iseegr8tfuldeadppl/BraillePrintingMachine/Other/DrawingMachine/gcode/48386743_604268526693747_9118755841934098432_n.png

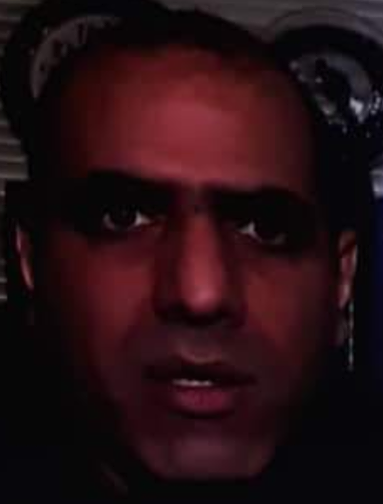
Other/DrawingMachine/gcode/48386743_604268526693747_9118755841934098432_n.png
