iseegr8tfuldeadppl/BraillePrintingMachine/Other/DrawingMachine/gcode/ok2.jpg

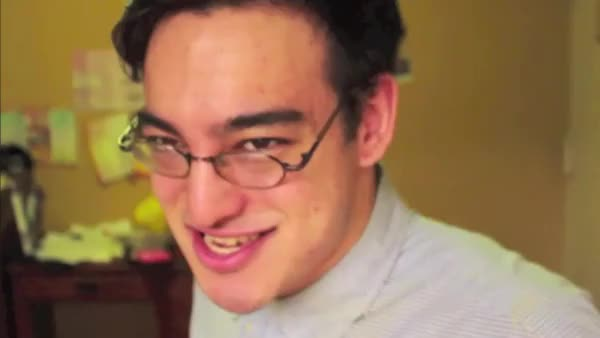
Other/DrawingMachine/gcode/ok2.jpg
