iseegr8tfuldeadppl/BraillePrintingMachine/Report/TODO REPORT.txt

X send report by email to urself n try to view it on browser to test pictures being visible
X follow given architecture 
X rename sources
X no stupid history
X don't talk about what you feel/think/thought
X project does not contain "you", "me",  "i"
X change your main goal according to what she said
X you have to format all the paragraphs using the tool option she mentioned
X remove any will and future
x remove any our and thought and think and assume and you

X wrrite entire report but in titles only
