iseegr8tfuldeadppl/BraillePrintingMachine/3DModels/braille.jpg

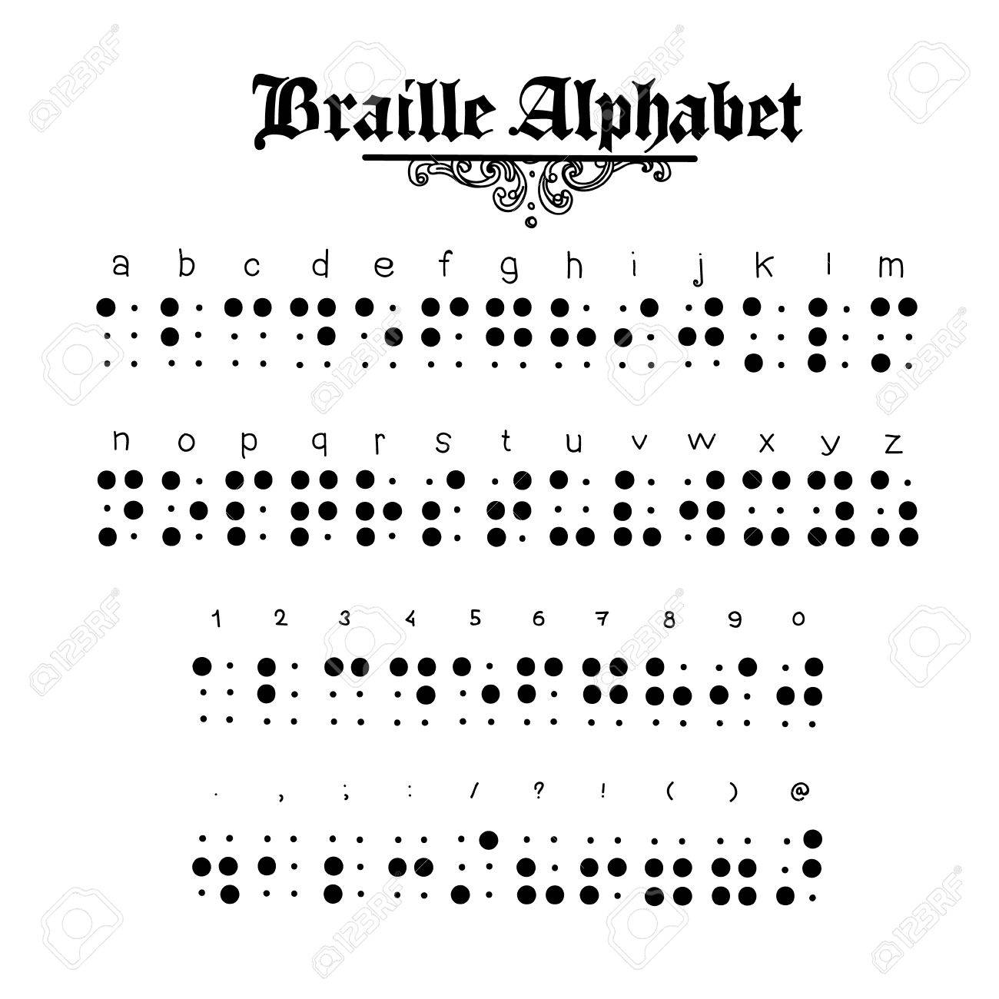
3DModels/braille.jpg
