iseegr8tfuldeadppl/BraillePrintingMachine/Other/DrawingMachine/gcode/2fake.png

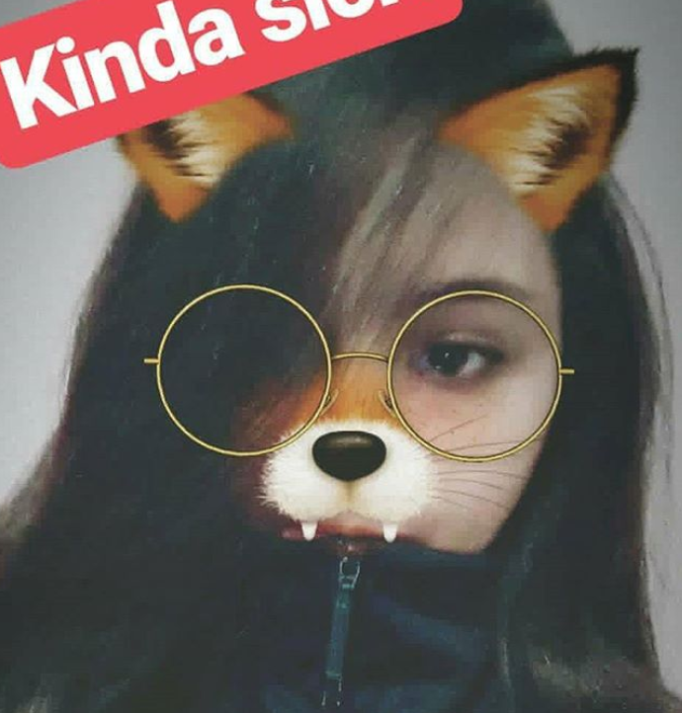
Other/DrawingMachine/gcode/2fake.png
