iseegr8tfuldeadppl/BraillePrintingMachine/Other/DrawingMachine/gcode/49095503_364993957612211_6874582120640020480_n.jpg

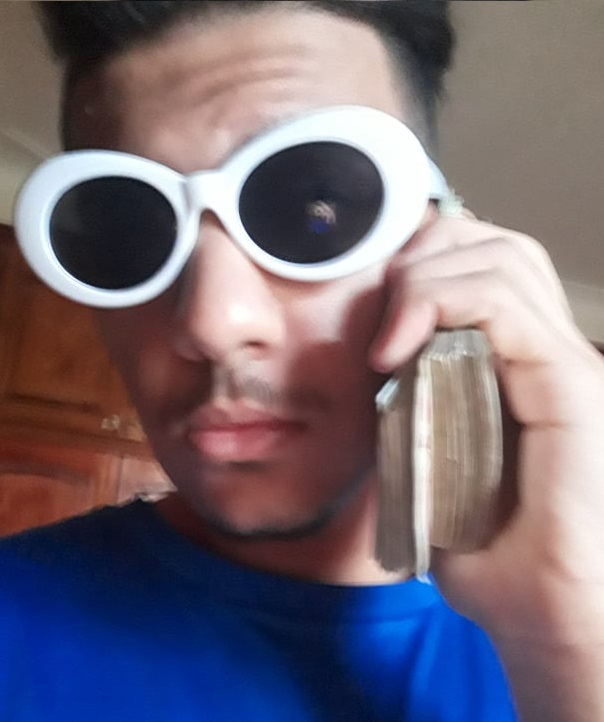
Other/DrawingMachine/gcode/49095503_364993957612211_6874582120640020480_n.jpg
