iseegr8tfuldeadppl/BraillePrintingMachine/Other/DrawingMachine/gcode/54405427_401156530697718_4848583370659069952_n.jpg

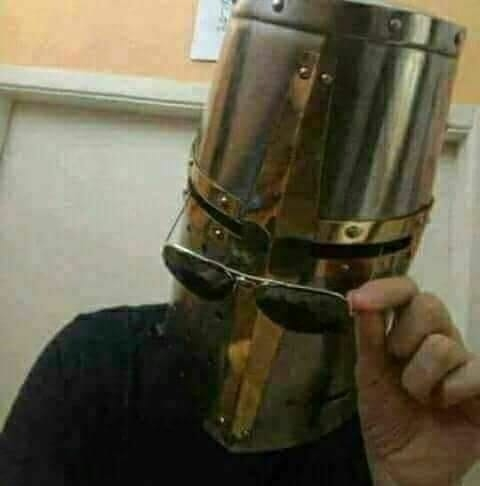
Other/DrawingMachine/gcode/54405427_401156530697718_4848583370659069952_n.jpg
