iseegr8tfuldeadppl/BraillePrintingMachine/Other/DrawingMachine/gcode/748185382cc3f726acdb8a884f4bbdc9.gif

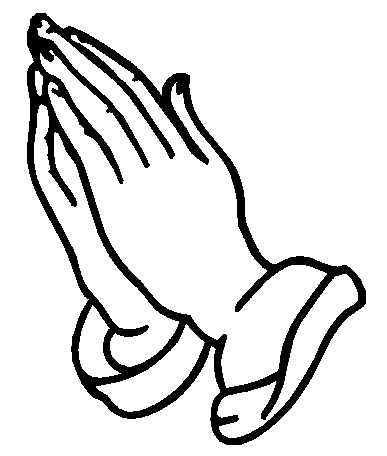
Other/DrawingMachine/gcode/748185382cc3f726acdb8a884f4bbdc9.gif
