iseegr8tfuldeadppl/BraillePrintingMachine/Other/DrawingMachine/gcode/ani.png

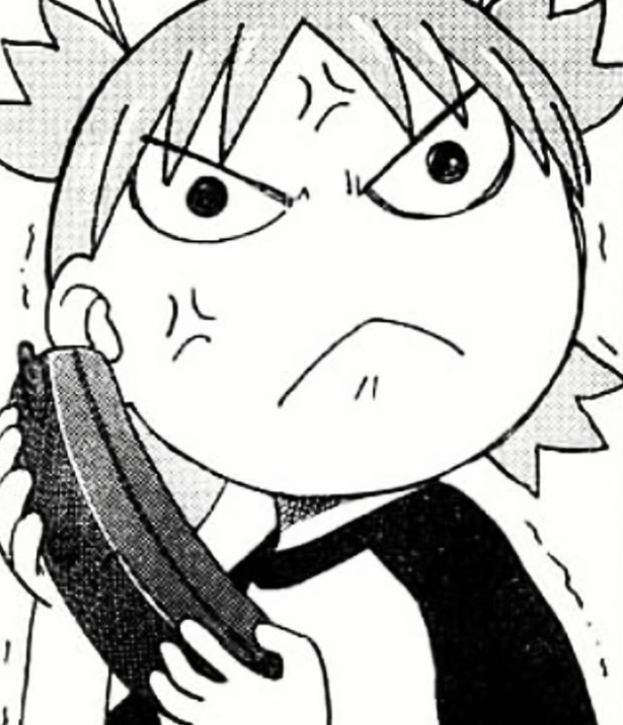
Other/DrawingMachine/gcode/ani.png
