iseegr8tfuldeadppl/BraillePrintingMachine/Other/DrawingMachine/gcode/earphone.png

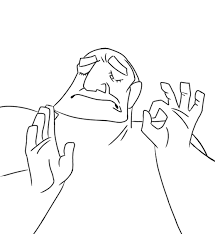
Other/DrawingMachine/gcode/earphone.png
