iseegr8tfuldeadppl/BraillePrintingMachine/Other/DrawingMachine/gcode/face.jpg

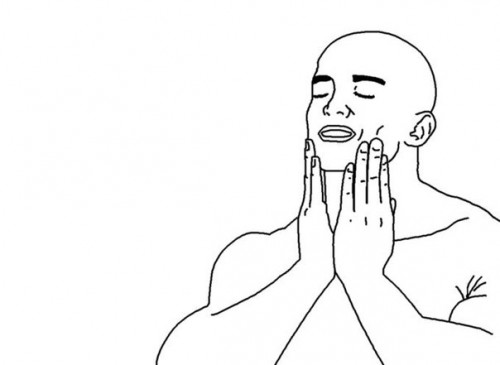
Other/DrawingMachine/gcode/face.jpg
