iseegr8tfuldeadppl/BraillePrintingMachine/Other/DrawingMachine/gcode/facy.jpg

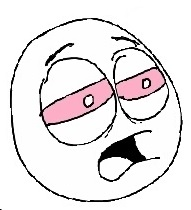
Other/DrawingMachine/gcode/facy.jpg
