iseegr8tfuldeadppl/BraillePrintingMachine/Other/DrawingMachine/gcode/fake.png

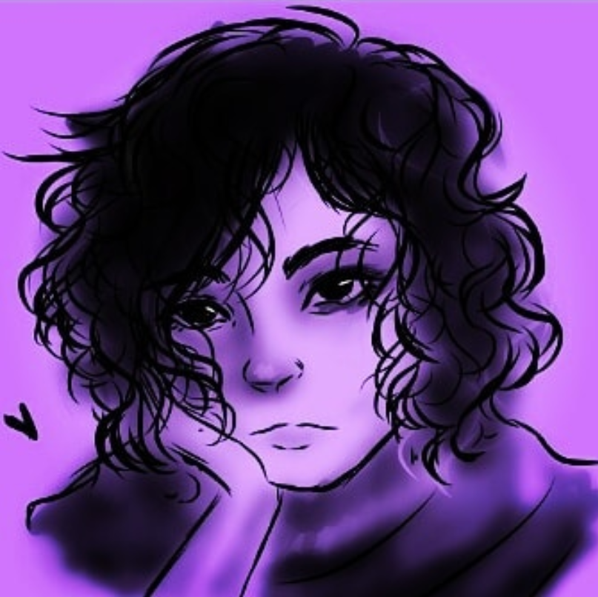
Other/DrawingMachine/gcode/fake.png
