iseegr8tfuldeadppl/BraillePrintingMachine/Other/DrawingMachine/gcode/ff.jpg

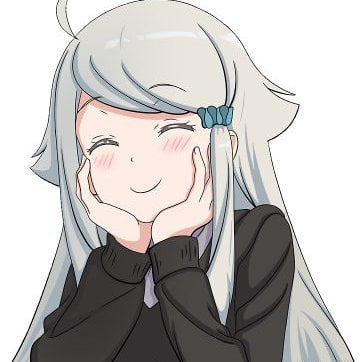
Other/DrawingMachine/gcode/ff.jpg
