iseegr8tfuldeadppl/BraillePrintingMachine/Other/DrawingMachine/gcode/lel.png

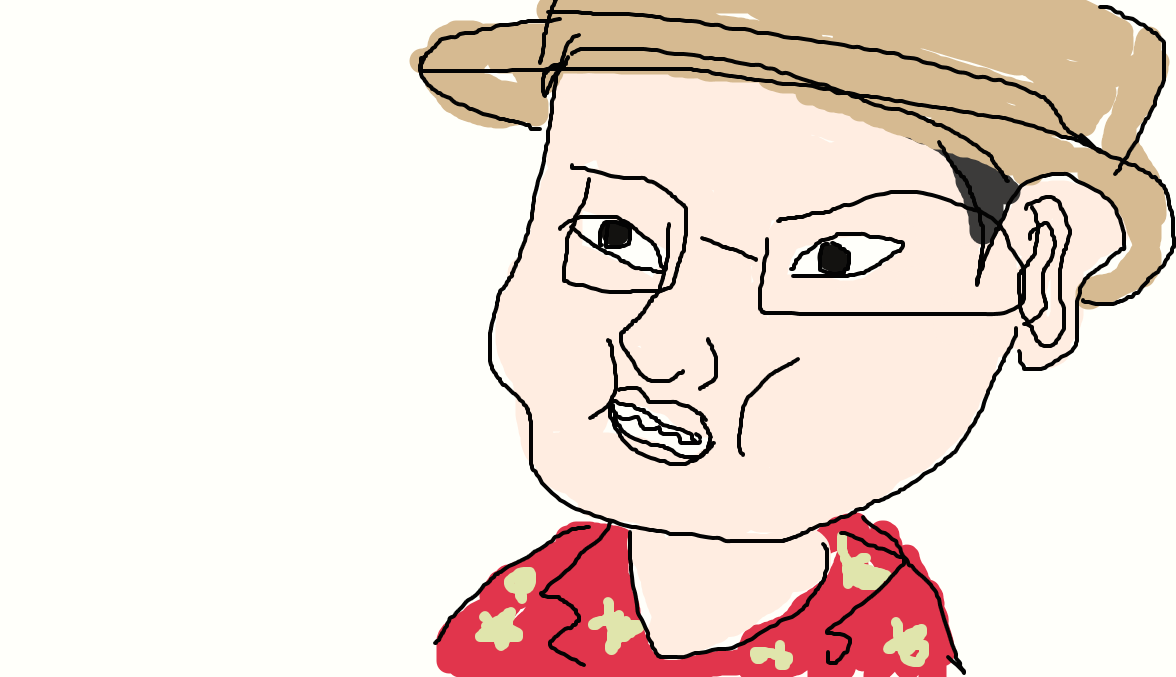
Other/DrawingMachine/gcode/lel.png
