iseegr8tfuldeadppl/BraillePrintingMachine/Other/DrawingMachine/gcode/ok.jpg

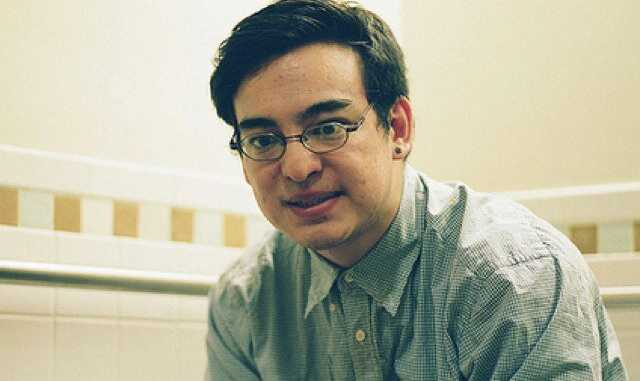
Other/DrawingMachine/gcode/ok.jpg
