iseegr8tfuldeadppl/BraillePrintingMachine/Other/DrawingMachine/gcode/P8.jpg

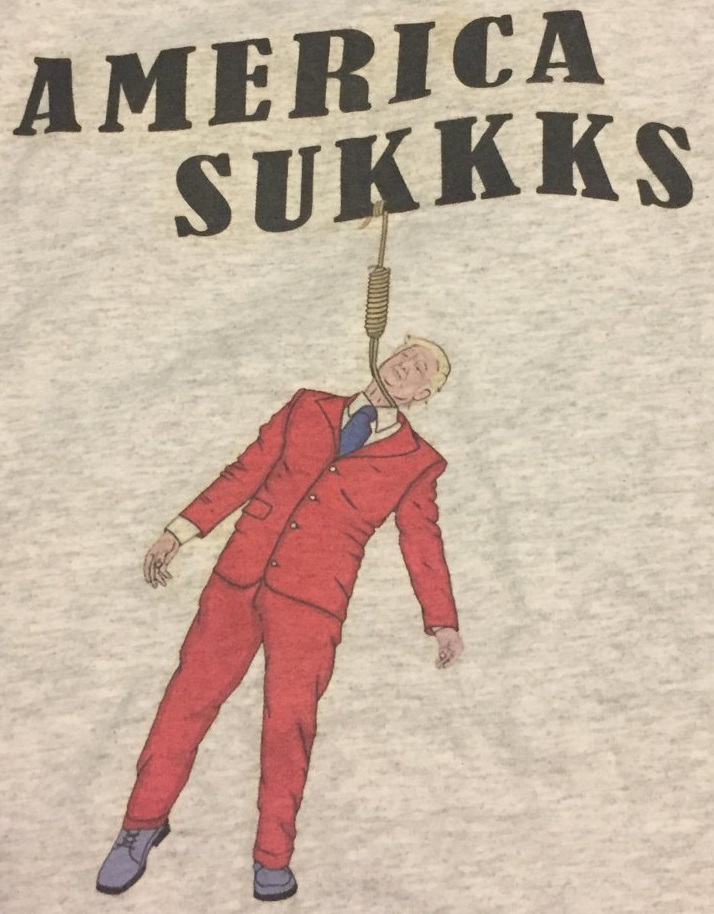
Other/DrawingMachine/gcode/P8.jpg
