iseegr8tfuldeadppl/BraillePrintingMachine/Other/DrawingMachine/gcode/Untitled.png

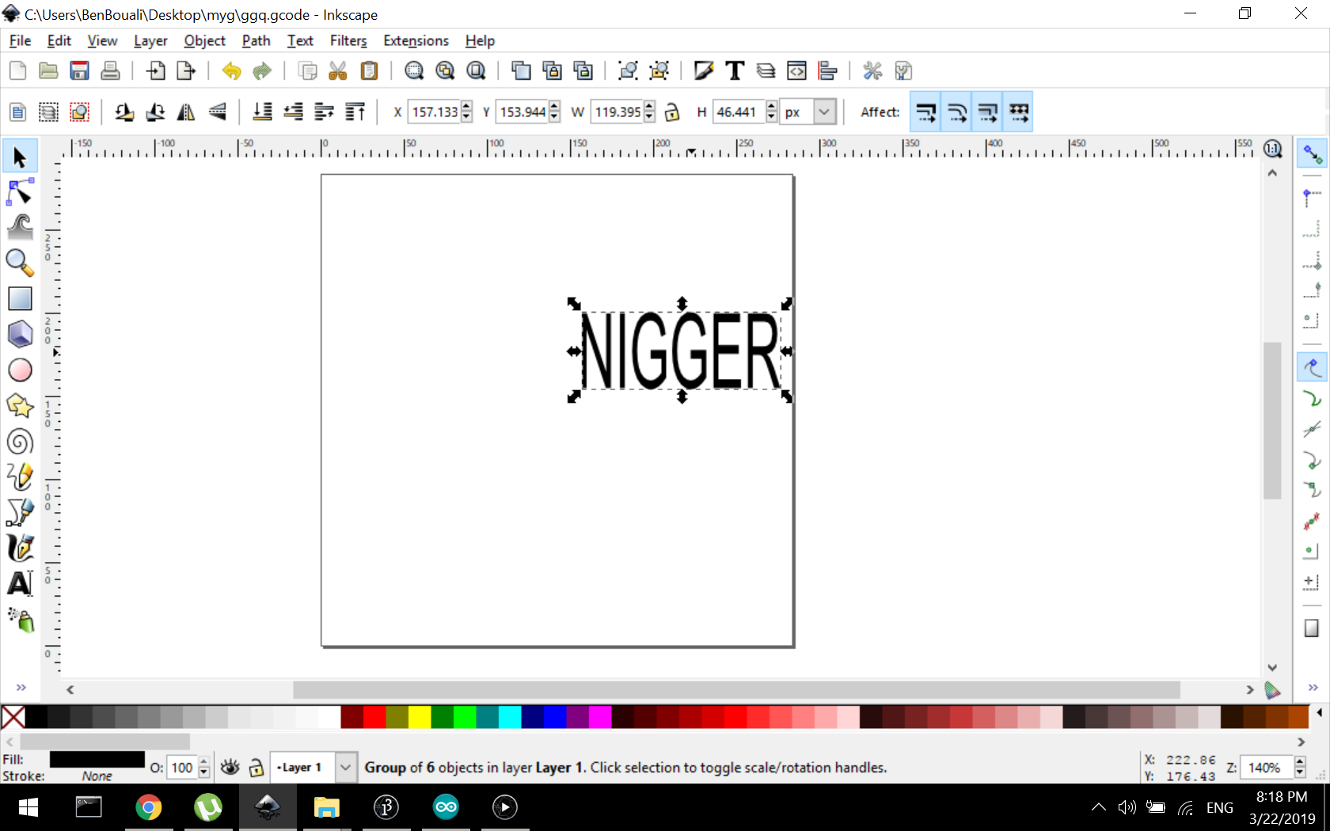
Other/DrawingMachine/gcode/Untitled.png
