iseegr8tfuldeadppl/BraillePrintingMachine/3DModels/butt/Learning the Moves.stl

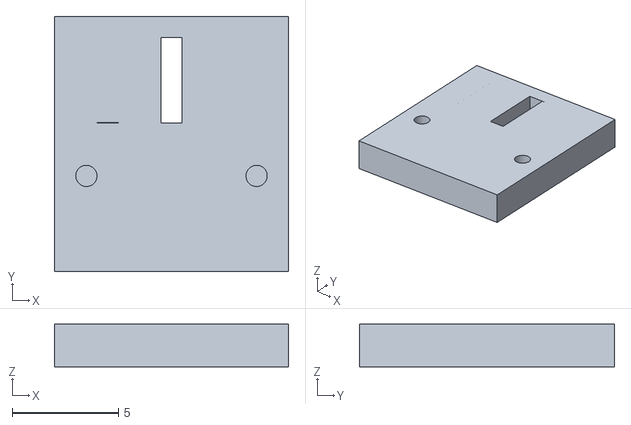
[picture p80: CAD file, 2020-06-29]
3DModels/butt/Learning the Moves.stl
11.0 x 12.0 x 2.00
