iseegr8tfuldeadppl/BraillePrintingMachine/3DModels/cylinders/cylinders.stl

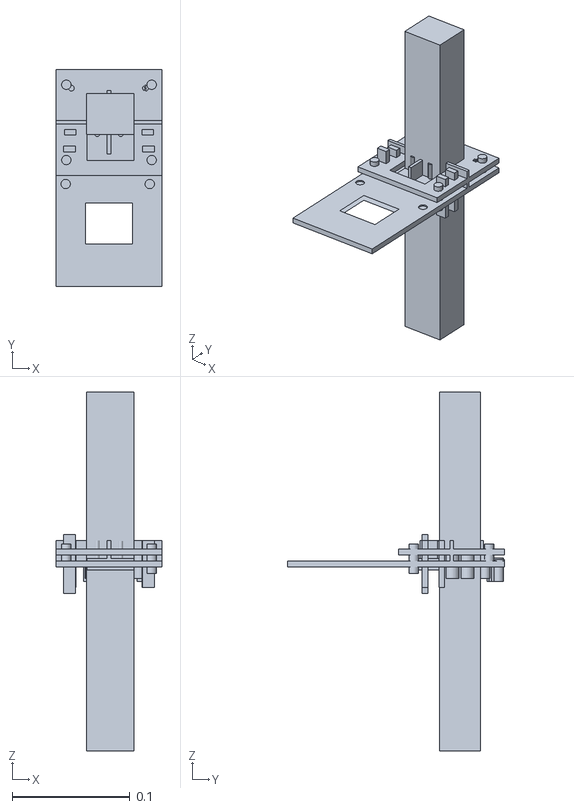
[picture p81: CAD file, 2020-06-29]
3DModels/cylinders/cylinders.stl
0.09 x 0.184 x 0.305
