iseegr8tfuldeadppl/BraillePrintingMachine/3DModels/drawinghead/drawinghead.stl

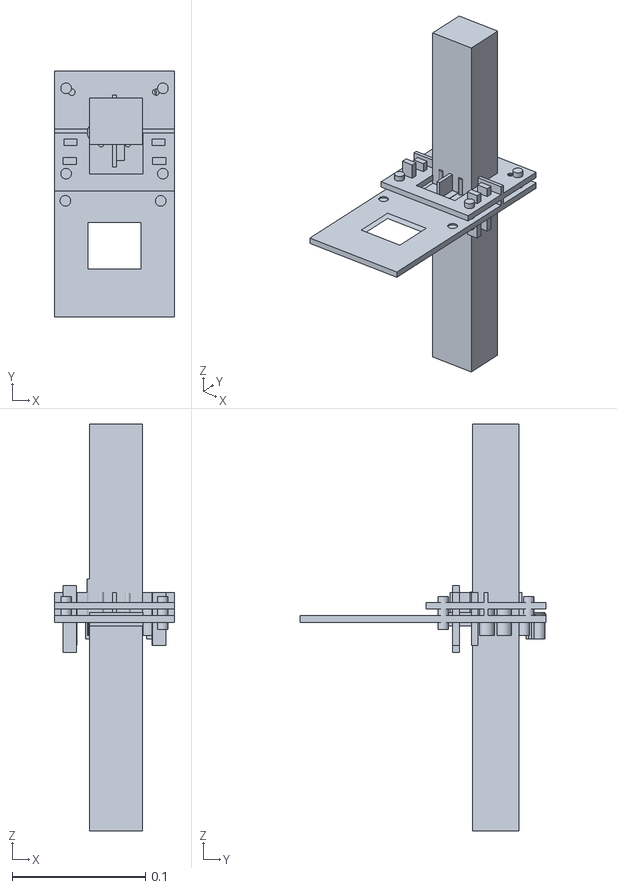
[picture p82: CAD file, 2020-06-29]
3DModels/drawinghead/drawinghead.stl
0.09 x 0.184 x 0.305
