iseegr8tfuldeadppl/BraillePrintingMachine/3DModels/head-drawer/Learning the Moves.stl

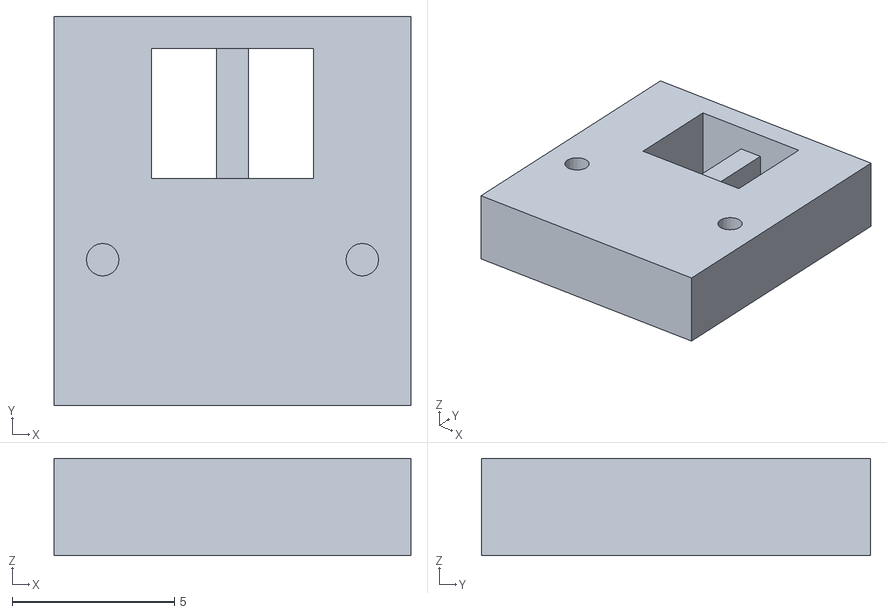
[picture p83: CAD file, 2020-06-29]
3DModels/head-drawer/Learning the Moves.stl
11.0 x 12.0 x 3.00
