iseegr8tfuldeadppl/BraillePrintingMachine/3DModels/middle-bottom/Learning the Moves.stl

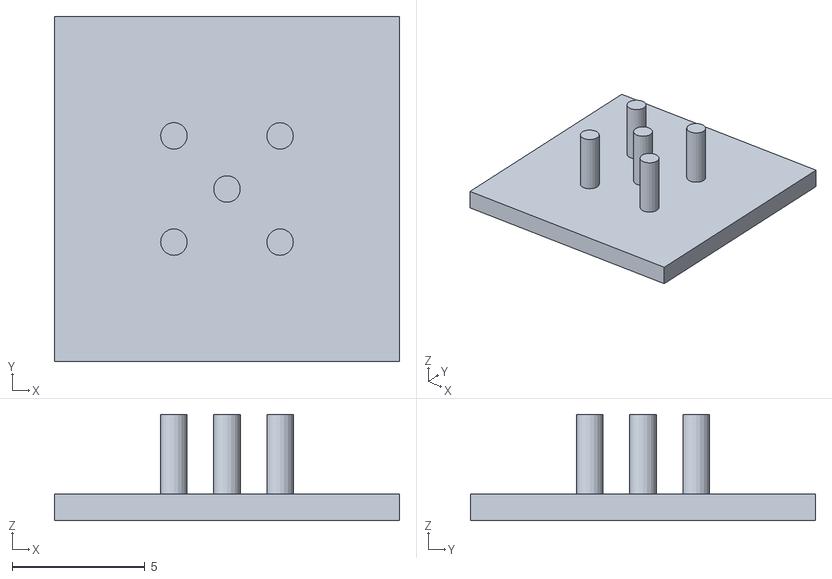
[picture p84: CAD file, 2020-06-29]
3DModels/middle-bottom/Learning the Moves.stl
13.0 x 13.0 x 4.00
