iseegr8tfuldeadppl/BraillePrintingMachine/3DModels/middletop/middletop.stl

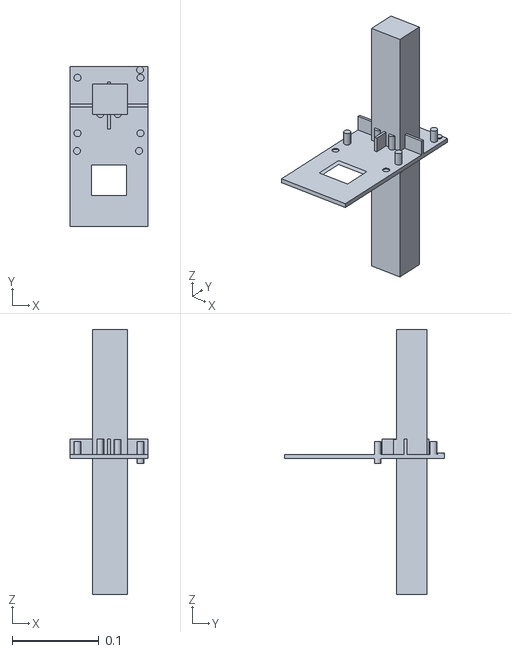
[picture p85: CAD file, 2020-06-29]
3DModels/middletop/middletop.stl
0.09 x 0.184 x 0.305
