iseegr8tfuldeadppl/BraillePrintingMachine/3DModels/butt/butt.stl

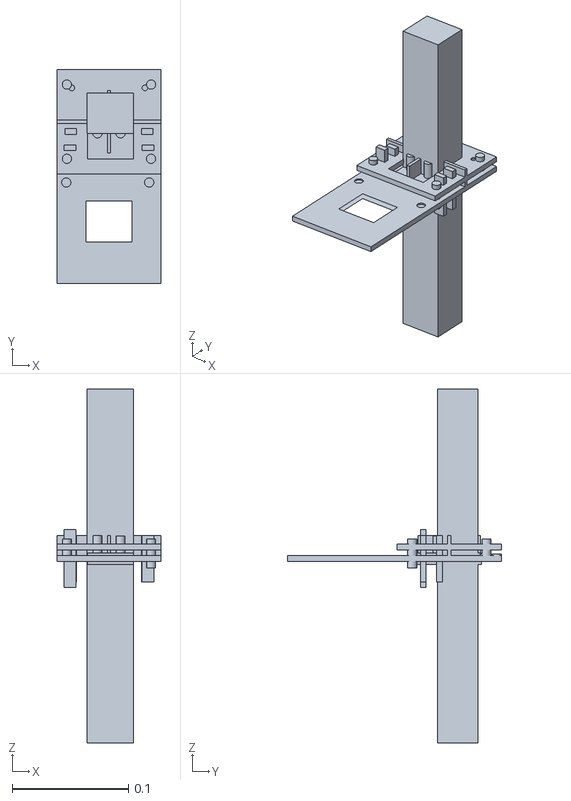
[picture p86: CAD file, 2020-06-29]
3DModels/butt/butt.stl
0.09 x 0.184 x 0.305
