iseegr8tfuldeadppl/BraillePrintingMachine/3DModels/head-drawer/headholder.stl

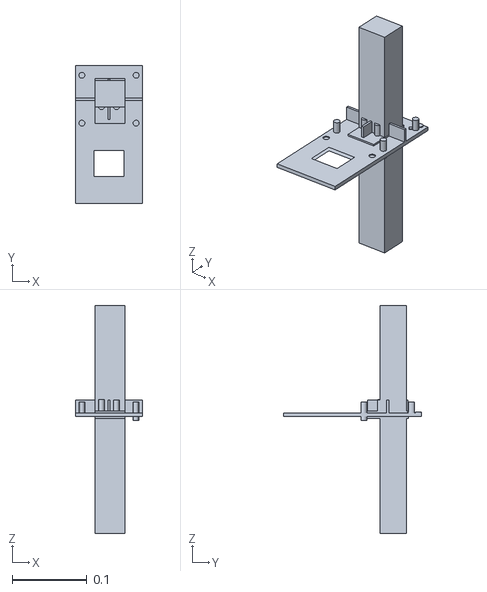
[picture p87: CAD file, 2020-06-29]
3DModels/head-drawer/headholder.stl
0.09 x 0.184 x 0.305
