iseegr8tfuldeadppl/BraillePrintingMachine/3DModels/sides/Learning the Moves.stl

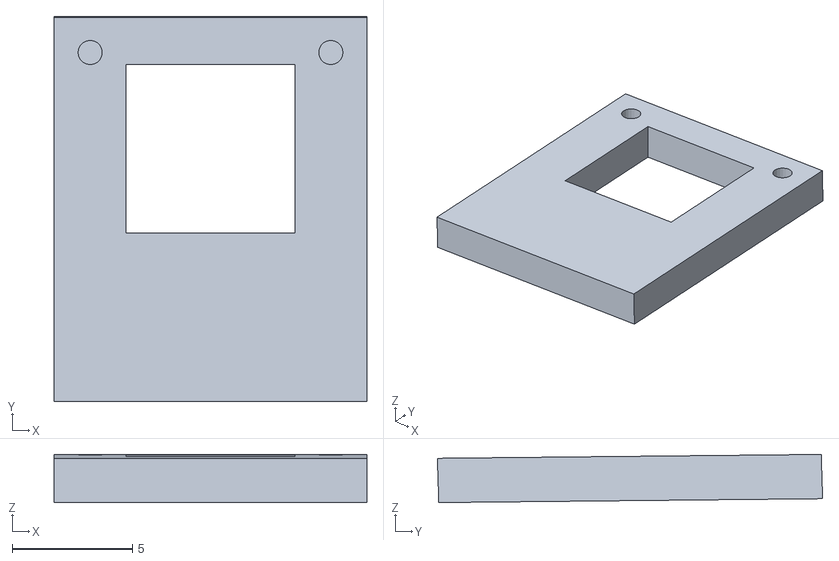
[picture p88: CAD file, 2020-06-29]
3DModels/sides/Learning the Moves.stl
13.0 x 16.0 x 2.00
