iseegr8tfuldeadppl/BraillePrintingMachine/(list of files, cad)

Other CAD files:
3DModels/middle-bottom/middlebottom.stl
3DModels/yes/middlebottom.stl
3DModels/sides/sides.blend
