iseegr8tfuldeadppl/BraillePrintingMachine/(commit log)

2020-07-01 third stepper lmao
2020-07-03 mirrored prints, width check added, custom text input implemented seemlessly, go home, sethome, removed checks from arduino ide, integrated converter.
2020-07-04 finished hooking converter to machine, first half successful test, processing 3 can control machine, temporary fix of pushing machine all the way forward to avoid horizontal inaccuracies, way lower c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
2020-07-05 complete y axis and center of machine rework, z axis improvements, code range enlarged, home is being set before every launch
    [BrailleArduinoExperimental.ino, BrailleProcessingExperimental.pde]
2020-07-11 solved power consumption using sleep pin on drivers
    [BrailleArduinoFinal.ino, BrailleProcessingFinal.pde]
2020-07-21 drawing machine canceled due to design requiring more precise material than regular wood.
